Modellbahn-Treff/Otter_VerteilerBaustein/hardware/Hauptplatine.kicad_pcb

## KiCad design hardware/Hauptplatine.kicad_pcb (2026-05-05)

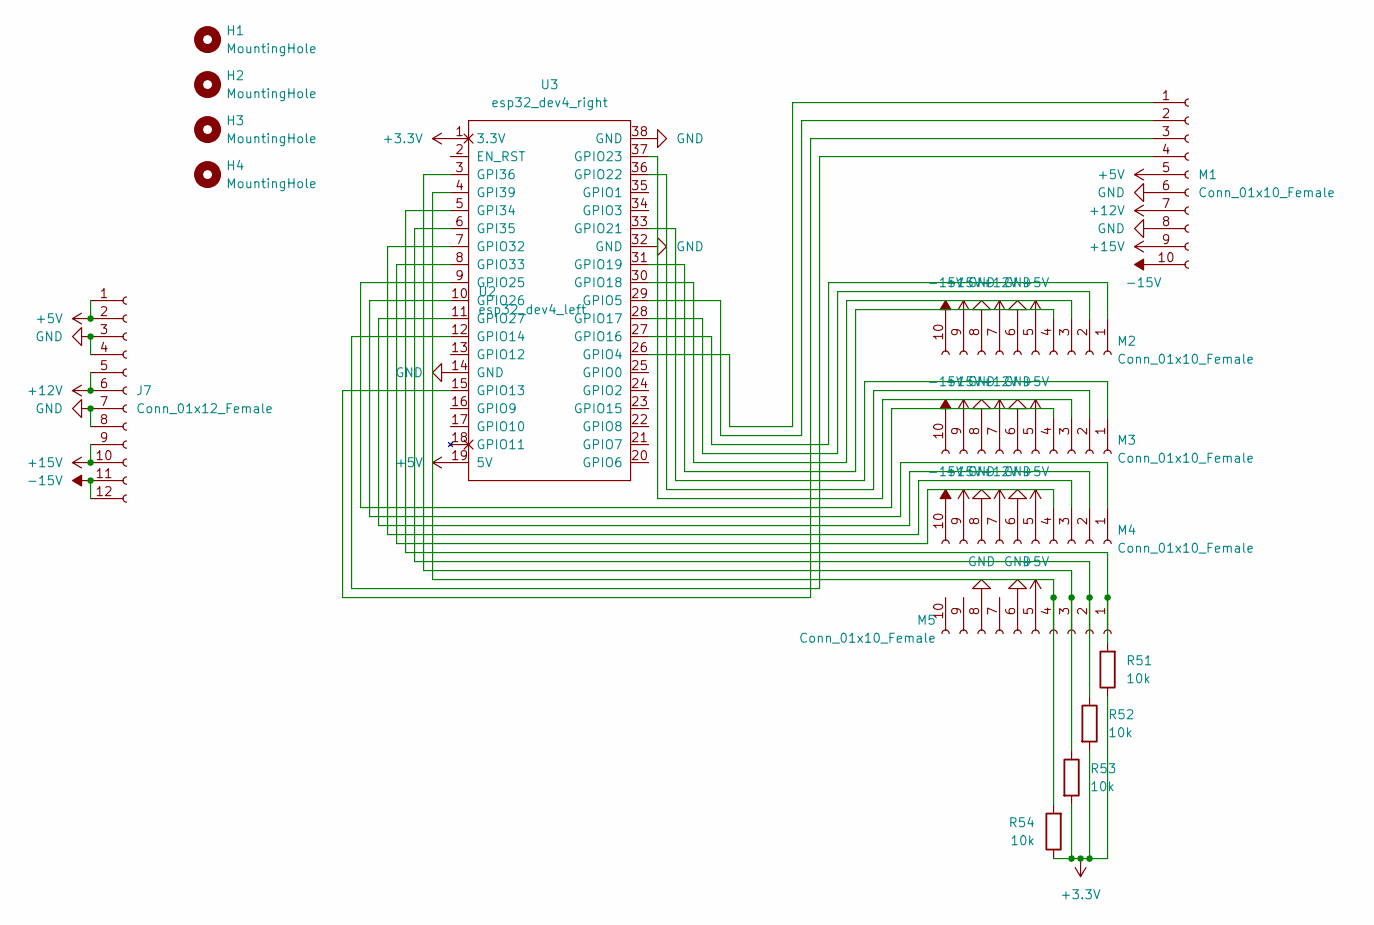
[picture p1: schematic Hauptplatine.kicad_sch]

Parts:
H1, H2, H3, H4: MountingHole; MountingHole_4.3mm_M4
J7: Conn_01x12_Female; 1729225
M1, M2, M3, M4, M5: Conn_01x10_Female; PinHeader_2x05_P2.54mm_Vertical_BKL
R51, R52, R53, R54: 10k; R_0805_2012Metric_Pad1.20x1.40mm_HandSolder
U2: esp32_dev4_left; esp32_dev_left
U3: esp32_dev4_right

Connections:
+3.3V: R51.1, R52.2, R53.2, R54.1, U2.1 (3.3V)
+5V: J7.1, J7.2, M1.5, M2.5, M3.5, M4.5, M5.5, U2.19 (5V)
+12V: J7.5, J7.6, M1.7, M2.7, M3.7, M4.7
+15V: J7.9, J7.10, M1.9, M2.9, M3.9, M4.9
-15V: J7.11, J7.12, M1.10, M2.10, M3.10, M4.10
GND: J7.3, J7.4, J7.7, J7.8, M1.6, M1.8, M2.6, M2.8, M3.6, M3.8, M4.6, M4.8, M5.6, M5.8, U2.14 (GND), U3.32 (GND), U3.38 (GND)
unnamed: M1.1, U3.26 (GPIO4)
unnamed: M1.2, U3.29 (GPIO5)
unnamed: M1.3, U2.15 (GPIO13)
unnamed: M1.4, U2.12 (GPIO14)
unnamed: M2.1, U3.27 (GPIO16)
unnamed: M2.2, U3.28 (GPIO17)
unnamed: M2.3, U3.30 (GPIO18)
unnamed: M2.4, U3.31 (GPIO19)
unnamed: M3.1, U3.33 (GPIO21)
unnamed: M3.2, U3.36 (GPIO22)
unnamed: M3.3, U3.37 (GPIO23)
unnamed: M3.4, U2.9 (GPIO25)
unnamed: M4.1, U2.10 (GPIO26)
unnamed: M4.2, U2.11 (GPIO27)
unnamed: M4.3, U2.7 (GPIO32)
unnamed: M4.4, U2.8 (GPIO33)
unnamed: M5.1, R51.2, U2.5 (GPI34)
unnamed: M5.2, R52.1, U2.6 (GPI35)
unnamed: M5.3, R53.1, U2.3 (GPI36)
unnamed: M5.4, R54.2, U2.4 (GPI39)

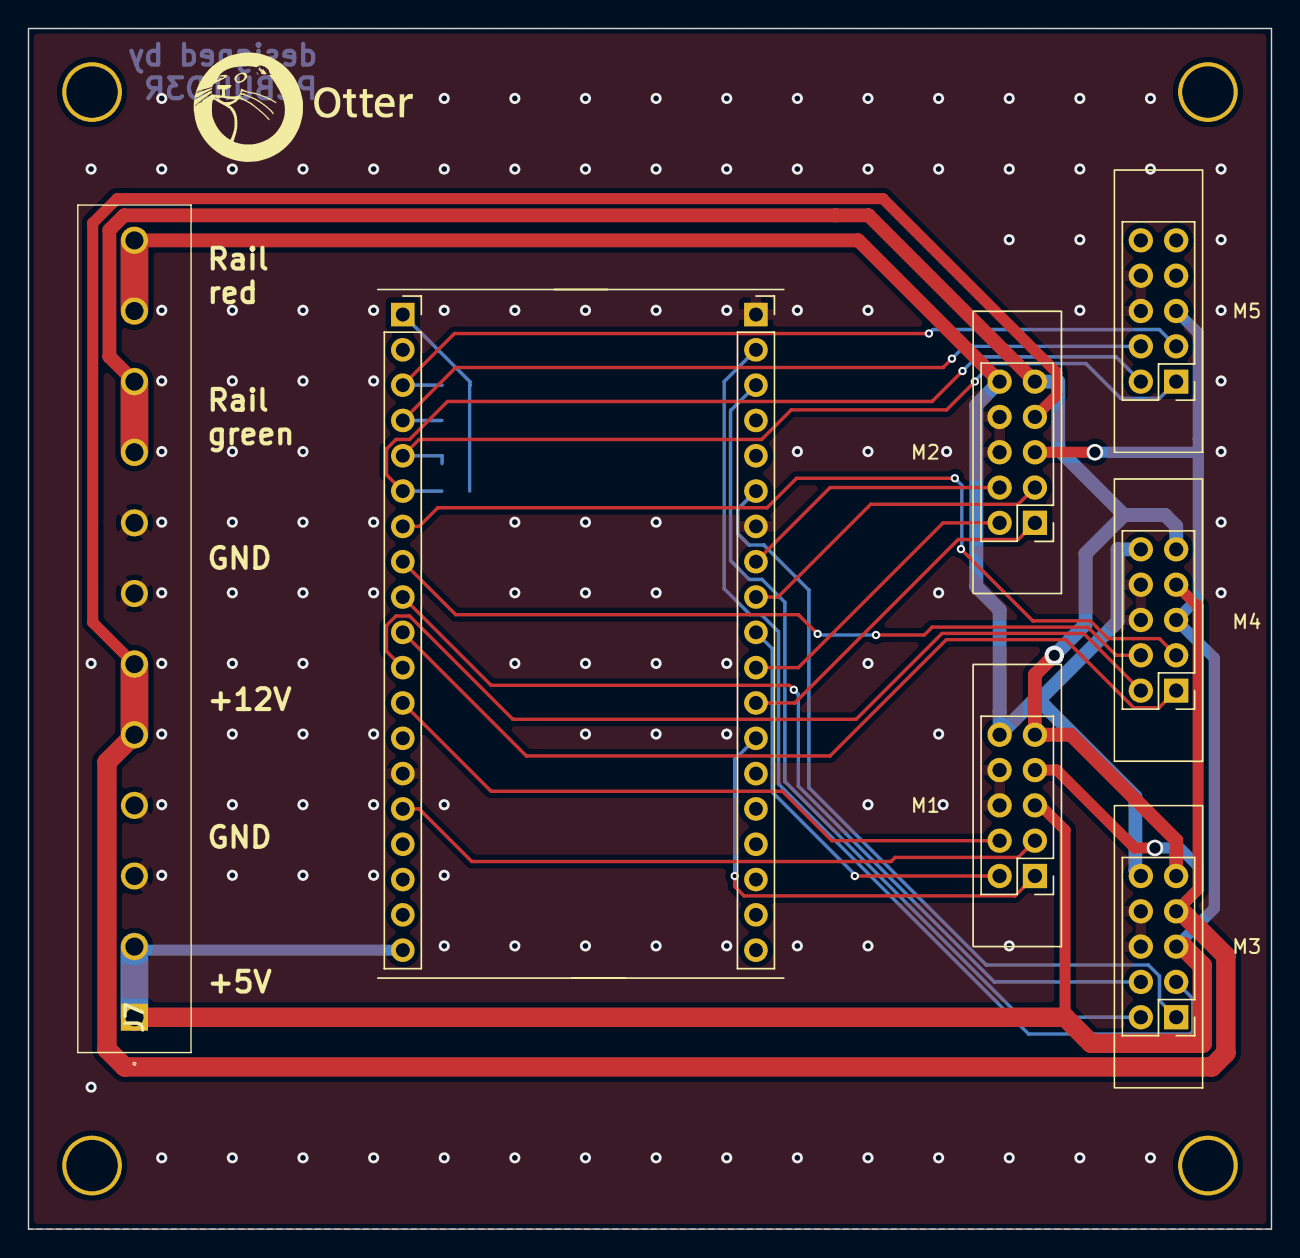
[picture p2: board Hauptplatine.kicad_pcb from above]

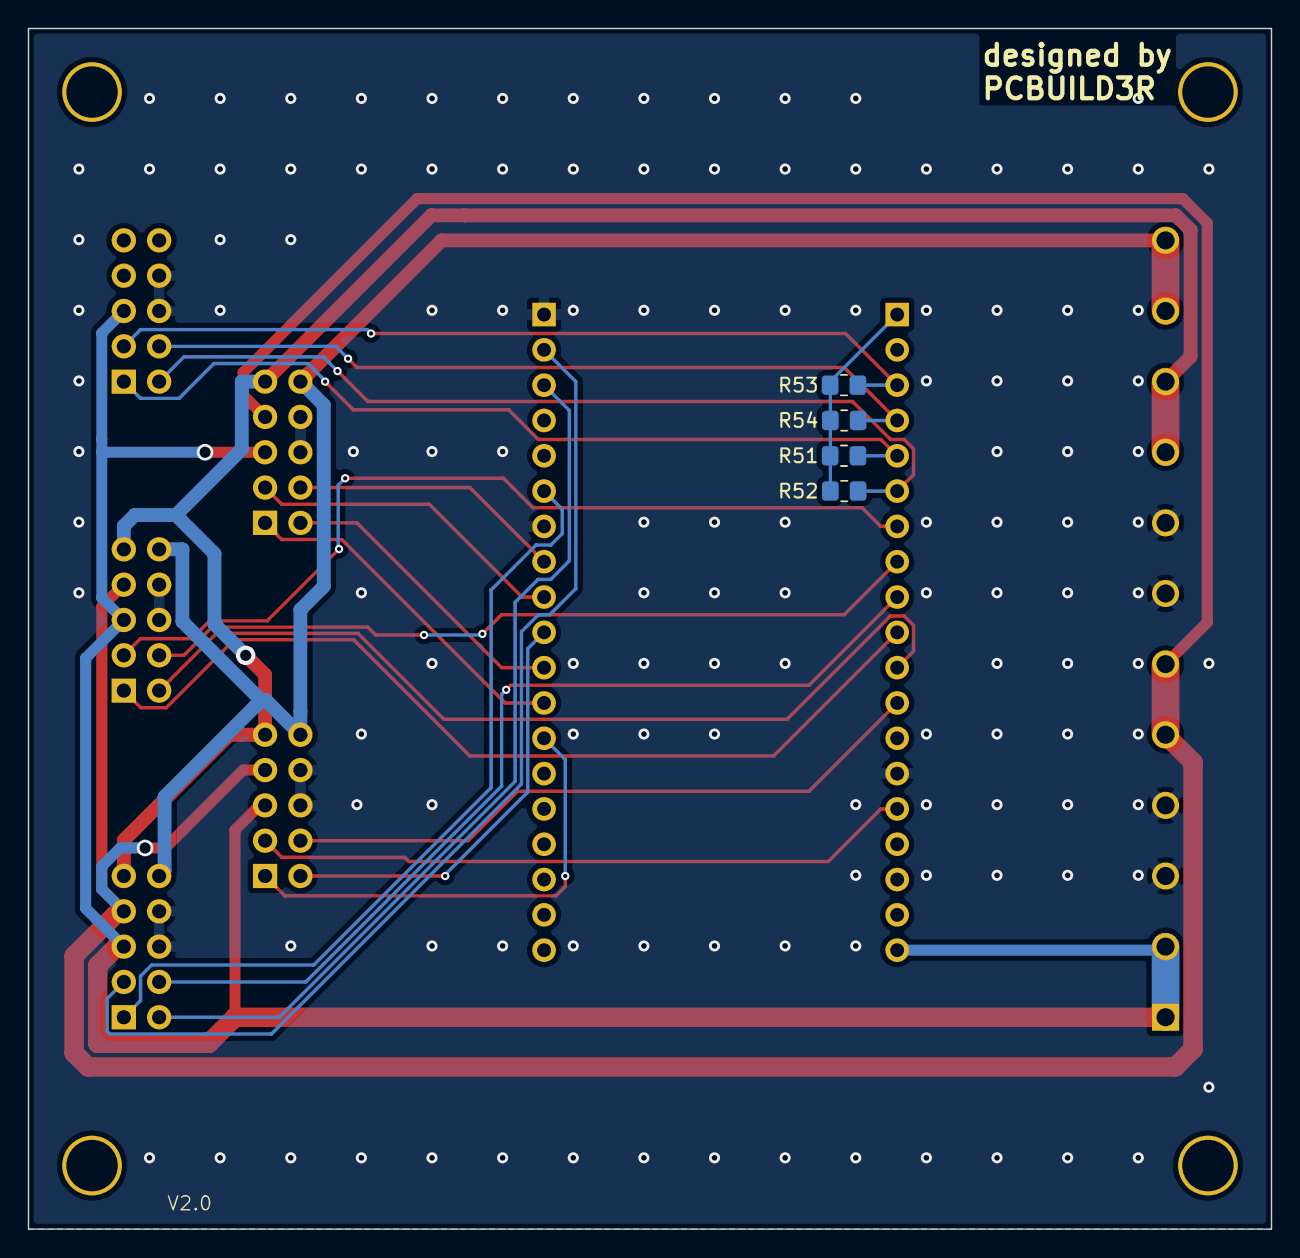
[picture p3: board Hauptplatine.kicad_pcb from below]

Board: 2 copper layers, 89.4 x 86.4 mm, 16 parts (4 on the bottom side), 26 nets.
