Modellbahn-Treff/Otter_VerteilerBaustein/firmware/main/otter.cpp

// Copyright (C) 2026 Modellbahn-Treff for Kids GmbH
// SPDX-License-Identifier: GPL-3.0-or-later

#include "otter.h"

const uint8_t Pin[20] = {4, 5, 13, 14, 16, 17, 18, 19, 21, 22, 23, 25, 26, 27, 32, 33, 34, 35, 36, 39};
const char *MqttRefresh = "otter/Refresh";
