Modellbahn-Treff/Otter_VerteilerBaustein/firmware/main/serial_config.h

// Copyright (C) 2026 Modellbahn-Treff for Kids GmbH
// SPDX-License-Identifier: GPL-3.0-or-later

#pragma once

// Start the Serial configuration console task.
// Call once from app_main() after nvs_flash_init().
void serial_config_start(void);
