Modellbahn-Treff/Otter_VerteilerBaustein/(commit log)

2026-05-05 final Design V2
    [Hauptplatine.kicad_pcb, Hauptplatine.kicad_sch]
2026-05-23 add firmware
    [Hauptplatine.kicad_pcb, Hauptplatine.kicad_sch]
2026-05-23 Add web interface and manifest for Otter VerteilerBaustein firmware flashing
    - Created index.html for the web interface, enabling users to flash firmware and configure WiFi settings directly from their browser.
    - Implemented a user-friendly layout with responsive design, including sections for flashing firmware and configuring WiFi credentials.
    - Added manifest.json to define the firmware build configuration for the ESP32 chip, specifying the necessary binary files and their offsets.
2026-05-23 Add log control buttons for console connection in index.html
2026-05-25 Update AusSchaltZeitWeiche to 200 for correct timing
    [settings.cpp]
2026-06-14 Add reboot functionality in settings_apply_json for MQTT requests
    [settings.cpp]
2026-06-14 Refactor settings handling to improve JSON parsing and NVS error reporting
    [main.cpp, serial_config.cpp, settings.cpp, settings.h]
2026-06-14 Fix MQTT ack never sent by using enqueue instead of publish
    [main.cpp]
2026-06-14 Improve MQTT reboot handling by delaying restart in a separate task
    [main.cpp]
